bontango/Gosof80/top/GOSOF80.vhd

-- Top level file for a Gottlieb compatible Soundboard
-- by bontango www.lisy.dev
-- 
-- This is free software: you can redistribute
-- it and/or modify it under the terms of the GNU General
-- Public License as published by the Free Software
-- Foundation, either version 3 of the License, or (at your
-- option) any later version.
--
-- This is distributed in the hope that it will
-- be useful, but WITHOUT ANY WARRANTY; without even the
-- implied warranty of MERCHANTABILITY or FITNESS FOR A
-- PARTICULAR PURPOSE. See the GNU General Public License
-- for more details.
--
-- HW 'GOSOF80' v2.1
-- Version 0.1 - rom read from SD card
-- Version 0.2 - rom read from SD card MA 216 & MA390
-- Version 0.3 - added MA55 support
-- Version 0.4 - with option DIP4 to on, romcode is read always from first secor ( sector #660 in fact)
-- Version 0.5 - MA490 support (SYS1 works partially)
-- Version 0.6 - SYS1 support
-- Version 0.7 - added Rocky
-- Version 0.8 - sb_opt(6) was on wrong IO ( PIN_51 instead of PIN_93)
---- 			 	- remark: sys1 playing only '10' & '1000' sounds is OK while game over is high!!
-- Version 0.9 - added background music with SYS1 & MA55
-- Version 0.91 -- added clock adjustment via options
-- Version 0.92 -- added matrix for striker & Qbert
-- Version 0.93 -- with LED_1 showing playing sounds
-- Version 0.94 -- activated folder 64 with all DIPs ON, CPU deactivated in this case
-- Version 0.95 -- added Caveman
-- Version 0.96 -- corrected Mars
-- Version 0.97 - attract speech for Mars, Volcano and Black Hole
-- Version 0.98 - Votrax SC-01 emulation (rtl/common/votrax, PinMAME's SC-01 model) for
--                MA-216 games, selected with DIP 2 ON. DIP 2 OFF = speech from MP3 as
--                before. Not on Cyclone II (variant_pkg HAS_VOTRAX = false).
--                Audio DAC now 10 bit: sound DAC + speech mixed with saturation.
--                Speech 1.0 = 512, tones x3 instead of x4 while the emulation runs.
--                HW 4.x (v4.01: CRC check, sound test, PLL) joins this tree as board 5.
--                Clock and option DIPs of HW 2.x as on HW 4.x, option DIPs (ON = '0'):
--                  DIP1 ON  CPU 1020 kHz, OFF 892 kHz (Gosof_PLL; was a 7 step divider)
--                  DIP2 ON  speech from the MP3 player, OFF Votrax emulation (MA-216)
--                  DIP3 ON  test switch = test switch of the original board,
--                       OFF test switch says "This is Gosof version x.98 from lisy dot dev"
--                  DIP4 ON  test mode: every sound as number from MP3 folder 64
--                           (was game_sel 000000 on HW 2.x; DIP4 "ROM from sector 660" is gone)
-- Version 0.99 - sound inputs S1..S16 are taken over only after they were stable for
--                SETTLE_CYCLES cpu_clk cycles (about 1 ms). Speech games drive S16 through the
--                driver board, it arrives later than S1..S8. The MA-216 program reads port A
--                once, about 20 cycles after the PA7 IRQ, and missed S16: no speech in the
--                game with the Votrax emulation (Black Hole, DIP 2 OFF). The MP3 path sent the
--                wrong file for sounds whose lower bits are speech themselves (BH 19, 29, 31).
--
-- Shared core of all board variants (HW 2.x: Cyclone II, Cyclone IV v3/v4, Cyclone 10;
-- HW 4.x: Cyclone 10). The board shells top\board_hw2x.vhd / top\board_hw4x.vhd
-- (entity gosof80) map their pins onto it; the SD card reader comes per board family
-- as entity sd_reader. Releases are named <BoardId>.<SwMinor>, e.g. 3.98 - board id in
-- variant.psd1, SwMinor in scripts\version.psd1, both reach the VHDL as generics
-- (set_parameter in the generated .qsf).

library ieee;
use ieee.std_logic_1164.all;
use ieee.numeric_std.all;
use work.variant_pkg.all;

entity gosof80_core is
	generic(
		BOARD_ID : natural := 0;
		SW_MINOR : natural := 0
	);
	port(
		clk_50	: in std_logic;
		reset_sw	: in std_logic;
		test_sw	: in std_logic;  -- test switch (Gottlieb test), '0' = pressed
		gosof_test	: in std_logic;  -- sound test switch (HW 4.x only), '0' = pressed
		Audio_O	: buffer std_logic;

		-- Sound input S1,S2,S4,S8,S16
		-- initial low due to 2803A on input of Gosof80
		Sound :	in 	std_logic_vector(4 downto 0);

		--Soudnboard Options S1 DIPs 1..6
		SB_Opt :	in 	std_logic_vector(1 to 6);

		game_sel	:	in 	std_logic_vector(5 downto 0);  -- game selection S2
		option   :	in 	std_logic_vector(3 downto 0);  -- GOSOF options

		-- signals for the board LEDs
		trigger_o	: out std_logic;  -- one of S1..S8 active
		pa7_o			: out std_logic;  -- RIOT PA7 (sound strobe as the CPU sees it)
		sd_error_o	: out std_logic;
		crc_error_o	: out std_logic;  -- '0' = CRC error (HW 4.x), '1' on HW 2.x

		-- DFPlayer
		DFP_txd	   : out STD_LOGIC;

		-- SDcard
		SD_CS : buffer 	std_logic;
		SD_MISO : in 	std_logic;
		SD_MOSI : buffer 	std_logic;
		SD_CLK : buffer 	std_logic

		);
end gosof80_core;

architecture rtl of gosof80_core is

	-- multi SD, type according to game select
	constant is_MA216 : std_logic_vector(2 downto 0):="000";
	constant is_MA309 : std_logic_vector(2 downto 0):="001";
	constant is_MA55 : std_logic_vector(2 downto 0):="010";
	constant is_MA490 : std_logic_vector(2 downto 0):="011";
	constant is_SYS1 : std_logic_vector(2 downto 0):="100";
	constant is_special : std_logic_vector(2 downto 0):="101";

	signal SB_type : 	std_logic_vector(2 downto 0);
	
	signal cpu_clk	   : std_logic; -- 892 KHz clock
	signal clk_892	   : std_logic; -- 892 KHz clock (Gosof_PLL c0)
	signal clk_1042	   : std_logic; -- 1020 KHz clock (Gosof_PLL c1, called 1042 since HW 4.x)
	signal phi2			: 	std_logic; -- CPU clock phase 2
	signal uart_clk	: std_logic; -- 9600 baud clock for uart
	signal reset_l		: 	std_logic; -- Ccontroled by SD card reader

	-- option DIPs (ON = '0' on the pin)
	signal opt_fast		: std_logic; -- DIP1 ON: CPU 1020 kHz
	signal opt_test		: std_logic; -- DIP4 ON: test mode, sounds as numbers (MP3 folder 64)
	signal test_game		: std_logic; -- test switch as the game sees it

	signal Sound_meta : 	std_logic_vector(4 downto 0);
	-- input settle filter (v0.99): 1000 cycles = 1.12 ms at 892 kHz, 0.98 ms at 1020 kHz
	constant SETTLE_CYCLES : natural := 1000;
	signal Sound_last   : 	std_logic_vector(4 downto 0) := (others => '0');
	signal Sound_stable : 	std_logic_vector(4 downto 0) := (others => '0');
	signal settle_cnt   : 	natural range 0 to SETTLE_CYCLES := 0;
	signal Sound_in : 	std_logic_vector(4 downto 0);   -- Sound_stable or the sound test
	signal trigger_sound	: std_logic;
	signal test_activ		: std_logic;
	signal test_sound		: std_logic_vector(4 downto 0);
	signal cpu_addr	:	std_logic_vector(15 downto 0);
	signal cpu_din		: 	std_logic_vector(7 downto 0);
	signal cpu_dout	:  std_logic_vector(7 downto 0);
	signal n_cpu_nmi	: 	std_logic;
	signal n_cpu_irq	:  std_logic;
	signal cpu_wr_n	:  std_logic;
	
	signal riot_dout	:  std_logic_vector(7 downto 0);
	signal riot_pa_i	:  std_logic_vector(7 downto 0);
	signal riot_pa_o	:  std_logic_vector(7 downto 0);
	signal riot_pb_i	:  std_logic_vector(7 downto 0);
	signal riot_pb_o	:	std_logic_vector(7 downto 0);
	signal riot_cs		:  std_logic;
	signal n_riot_irq : std_logic;
	signal riot_rs_n  : std_logic;	
	signal addr_6532  :	std_logic_vector(4 downto 0);
	
	-- ROM
	signal soundrom1_dout	:	std_logic_vector(7 downto 0);
	signal soundrom2_dout	: 	std_logic_vector(7 downto 0);	
	
	-- address decoding helper
	signal soundrom1_cs		: std_logic;
	signal soundrom2_cs		: std_logic;
	signal soundrom1_addr	:  std_logic_vector(10 downto 0);
	signal soundrom2_addr	:  std_logic_vector(10 downto 0);
	signal wr_soundrom1		: std_logic;
	signal wr_soundrom2		: std_logic;
			
	-- RAM
	signal RAM_dout	: 	std_logic_vector(7 downto 0);
	signal RAM_cs		:  std_logic;
    
	-- sounds
	signal DAC_latch	:  std_logic;
	signal audio_dat_latch	: 	std_logic_vector(7 downto 0);
   signal audio_dat	: 	std_logic_vector(7 downto 0);	
	
	-- speech
	signal DAC_latch_speech	:  std_logic;
	signal sc01_strobe	:  std_logic;
	signal sc01_AR			:  std_logic;
	signal sc01_cs			:  std_logic;
	signal sc01_AR_timing	:  std_logic; -- A/R of the old timing-only SC01 (MP3 speech)

	-- Votrax SC-01 emulation (MA-216, option DIP 2 OFF) and the version announcement
	signal votrax_on		:  std_logic;
	signal vtx_ar			:  std_logic;
	signal vtx_audio		:  signed(15 downto 0);
	signal audio_mix		:  std_logic_vector(9 downto 0);
	signal ann_enable		:  std_logic; -- option DIP 3 OFF: test switch says the version
	signal ann_busy		:  std_logic;

	signal send_flag	:  std_logic:='0';
	signal DFcmd_cmd	:  std_logic_vector(7 downto 0);
	signal DFcmd_par1	:  std_logic_vector(7 downto 0);
	signal DFcmd_par2	:  std_logic_vector(7 downto 0);	
	
	-- background sound 
	signal bg_send_flag	:  std_logic:='0';
	signal bg_DFcmd_cmd	:  std_logic_vector(7 downto 0);
	signal bg_DFcmd_par1	:  std_logic_vector(7 downto 0);
	signal bg_DFcmd_par2	:  std_logic_vector(7 downto 0);	
	
	signal speech_ctrl :  std_logic_vector(31 downto 0);
	
	-- SD card
	signal address_sd_card	:  std_logic_vector(15 downto 0);
	signal data_sd_card	:  std_logic_vector(7 downto 0);
	signal wr_rom			:  std_logic;
	signal bg_on			:  std_logic; -- background music via the MP3 player
			
	-- MA490 only	
	signal ma490_irq_n			: std_logic;
	signal ma490_U11_q			: std_logic;
	
	-- attract mode
	signal attract_sound	:  std_logic_vector(7 downto 0);
	signal attract_send_flag	:  std_logic:='0';	
	signal number_of_attract_sounds : integer;
		
begin

-- do some signaling (the board shell drives its LEDs from these)
trigger_o <= trigger_sound;
pa7_o <= riot_pa_i(7);

-- option DIPs, see the header
opt_fast <= not option(0);
opt_test <= not option(3);

-- what type of soundboard do we emulate?
	SB_type <=  is_MA216 when game_sel( 5 downto 3) = "111" else
					is_MA309 when game_sel( 5 downto 4) = "11" else
					is_MA55 when game_sel( 5 downto 4) = "10" else
					is_MA490 when game_sel( 5 downto 4) = "01" else
					is_SYS1 when game_sel( 5 downto 4) = "00" else
					is_special;

	
META1: entity work.Cross_Slow_To_Fast_Clock_Bus
port map(
   i_D => Sound,
	o_Q => Sound_meta,
   i_Fast_Clk => cpu_clk	
	--i_Fast_Clk => clk_50
	);

-- settle filter (v0.99): Sound_stable follows Sound_meta only after all five lines were
-- unchanged for SETTLE_CYCLES. S16 comes through the driver board of the game and arrives
-- later than S1..S8; without the filter the PA7 IRQ fired and the MA-216 program read
-- port A before S16 was there.
Settle: process(cpu_clk) is
begin
	if rising_edge(cpu_clk) then
		if Sound_meta /= Sound_last then
			Sound_last <= Sound_meta;
			settle_cnt <= 0;
		elsif settle_cnt < SETTLE_CYCLES then
			settle_cnt <= settle_cnt + 1;
		else
			Sound_stable <= Sound_last;
		end if;
	end if;
end process;

-- sound test (HW 4.x, switch Gosof_Test): plays sound 1..31, 5 s each
Sound_in <= Sound_stable when test_activ = '0' else test_sound;

gen_soundtest: if IS_HW4 generate
	STEST: entity work.soundtest
	port map(
		i_Rst_L	=> reset_l,
		clk_in	=> uart_clk,
		start 	=> gosof_test,
		test_activ => test_activ,
		sound => test_sound
		);
end generate;
gen_no_soundtest: if not IS_HW4 generate
	test_activ <= '0';
	test_sound <= (others => '0');
end generate;

DFP_send: entity work.DFPlayer_Mini_CMD
port map(
			DFcmd_cmd => DFcmd_cmd,
			DFcmd_par1 => DFcmd_par1,
			DFcmd_par2 => DFcmd_par2,
         send_flag => send_flag,
         clk => uart_clk,
         rst => reset_l,
         txd => DFP_txd
);

-- timing only SC-01 (A/R), used while the speech comes from the MP3 player
SC01_Simu: entity work.SC01
port map(
         clk => clk_50,
			strobe => sc01_strobe,
			cpu_data => cpu_dout(5 downto 0),
			AR => sc01_AR_timing,
         rst => reset_l
);

-- Votrax SC-01 emulation: MA-216 games with option DIP 2 OFF (not in the test mode,
-- which plays numbers from MP3). Then MP3 speech and attract MP3 are off.
votrax_on <= '1' when HAS_VOTRAX and SB_type = is_MA216 and option(1) = '1' and opt_test = '0' else '0';
-- while the version announcement runs, the CPU sees a ready SC-01 (no NMIs from A/R)
sc01_AR <= sc01_AR_timing when votrax_on = '0' else
           '1' when ann_busy = '1' else
           vtx_ar;

-- Test switch: with option DIP 3 OFF (and the emulation built in) it says the version,
-- the game sees it open. With DIP 3 ON it is the test switch of the original board.
ann_enable <= '1' when HAS_VOTRAX and option(2) = '1' else '0';
test_game <= '1' when ann_enable = '1' else test_sw;

gen_votrax: if HAS_VOTRAX generate
	signal speech_clk_latch	:  std_logic_vector(7 downto 0); -- $3000, SC-01 clock
	signal vtx_mute_stb		:  std_logic;
	signal vtx_stb			:  std_logic;
	signal vtx_data		:  std_logic_vector(7 downto 0);
	signal vtx_clk_ctrl	:  std_logic_vector(7 downto 0);
	signal ann_start		:  std_logic;
	signal ann_stb			:  std_logic;
	signal ann_data		:  std_logic_vector(7 downto 0);
	signal test_s			:  std_logic_vector(2 downto 0) := "111";
	signal deb_cnt			:  unsigned(19 downto 0) := (others => '0'); -- 21 ms at 50 MHz
	signal test_deb		:  std_logic := '1';
begin
	-- debounce the test switch: a level counts once it held for 2^20 clocks (21 ms)
	Test_Debounce: process(clk_50) is
	begin
		if rising_edge(clk_50) then
			test_s <= test_s(1 downto 0) & test_sw;
			ann_start <= '0';
			if test_s(2) = test_deb then
				deb_cnt <= (others => '0');
			else
				deb_cnt <= deb_cnt + 1;
				if deb_cnt = (deb_cnt'range => '1') then
					test_deb <= test_s(2);
					ann_start <= ann_enable and not test_s(2);  -- pressed
				end if;
			end if;
		end if;
	end process;

	ANNOUNCE: entity work.vtx_announce
	generic map (BOARD_ID => BOARD_ID, SW_MINOR => SW_MINOR)
	port map(
		clk   => clk_50,
		rst_n => reset_l,
		start => ann_start,
		ar    => vtx_ar,
		busy  => ann_busy,
		stb   => ann_stb,
		data  => ann_data
	);

	-- $3000: D/A converter for the SC-01 clock (0x7E = 720 kHz, games lower it for TILT)
	Speech_Clock_Latch: process(clk_50) is
	begin
		if rising_edge(clk_50) then
			if reset_l = '0' then
				speech_clk_latch <= x"7E";
			elsif dac_latch_speech = '1' then
				speech_clk_latch <= cpu_dout;
			end if;
		end if;
	end process;

	-- PinMAME gts80s.c: a write to $7000-$7FFF (the ROM area, the program writes there
	-- as a delay) mutes the speech until the next phoneme write to $2000
	vtx_mute_stb <= '1' when cpu_addr(14 downto 12) = "111" and cpu_wr_n = '0' and cpu_clk = '0'
	                         and votrax_on = '1' and ann_busy = '0' else '0';

	-- the bus of the SC-01: the announcement while it runs, else the MA-216 CPU
	vtx_stb      <= ann_stb when ann_busy = '1' else sc01_strobe and votrax_on;
	vtx_data     <= ann_data when ann_busy = '1' else cpu_dout;
	vtx_clk_ctrl <= x"7E" when ann_busy = '1' else speech_clk_latch;

	VOTRAX: entity work.votrax_sc01
	generic map (G_TICK_DIV => 0)
	port map(
		clk       => clk_50,
		rst_n     => reset_l,
		stb       => vtx_stb,
		data      => vtx_data,
		mute_stb  => vtx_mute_stb,
		clk_ctrl  => vtx_clk_ctrl,
		ar        => vtx_ar,
		audio     => vtx_audio,
		audio_stb => open,
		tick_o    => open
	);
end generate;
gen_no_votrax: if not HAS_VOTRAX generate
	vtx_ar    <= '1';
	vtx_audio <= (others => '0');
	ann_busy  <= '0';
end generate;


-- phase 2 is complement of CPU clock
phi2 <= not(cpu_clk); 

-- IRQ signals ( should be '1')
n_cpu_irq <= n_riot_irq when ( SB_type = is_MA216 or SB_type = is_MA309 ) else
				 ma490_irq_n when ( SB_type = is_MA490 ) else
				 '1';

-- JK flip-flop on the piggyback board triggers CPU IRQ
ma490_U11_q <= not (riot_pb_i(0) or riot_pb_i(1) or riot_pb_i(2) or riot_pb_i(3));
U10: process(ma490_U11_q, riot_pb_o(6))
begin
	if riot_pb_o(6) = '0' then
		ma490_irq_n <= '1';
	elsif falling_edge(ma490_U11_q) then 
		ma490_irq_n <= '0';
	end if;
end process;

-- Address decoding here, cpu address bus 14-12 connect to 74LS138, only a few are used on non-speech board
--'000' riot cs
--'001' dac latch (sound)
--'010' SC01 latch 
--'011' dac latch (speech)
--'111' rom enable
riot_rs_n <= cpu_addr(9); -- ram select for riot RS_N = '0' do select ram
riot_cs 		<= '1' when cpu_addr(14 downto 12) ="000" and riot_rs_n='1' and ( SB_type = is_MA216 or SB_type = is_MA309 ) else
					'1' when cpu_addr(11 downto 10) ="00" and riot_rs_n='1' and ( SB_type = is_MA55 or SB_type = is_MA490 or SB_type = is_SYS1 ) else
					 '0';
ram_cs 		<= '1' when cpu_addr(14 downto 12) ="000" and riot_rs_n='0' and ( SB_type = is_MA216 or SB_type = is_MA309 ) else
					'1' when cpu_addr(11 downto 10) ="00" and
					riot_rs_n='0' and ( SB_type = is_MA55 or SB_type = is_MA490 or SB_type = is_SYS1 ) else
					'0';
soundrom1_cs 		<= '1' when cpu_addr(14 downto 11) ="1110" and ( SB_type = is_MA216 or SB_type = is_MA309 ) else
							'1' when cpu_addr(11 downto 10) ="01" and ( SB_type = is_MA55 or SB_type = is_SYS1 )else -- 0x0400 - 0x07FF & Mirror 0x0800 - 0x0BFF
							'1' when cpu_addr(11 downto 10) ="10" and ( SB_type = is_MA55 or SB_type = is_SYS1 )else -- Mirror 0x0800 - 0x0BFF
							'1' when cpu_addr(11) ='1' and SB_type = is_MA490 else
							'0';
soundrom2_cs 		<= '1' when cpu_addr(14 downto 11) ="1111" and ( SB_type = is_MA216 or SB_type = is_MA309 ) else
							'1' when cpu_addr(11 downto 10) ="11" and ( SB_type = is_MA55 or SB_type = is_SYS1 ) else -- 0x0C00 - 0x0FFF
							'0';
					
--MA only					
dac_latch 	<= '1' when cpu_addr(14 downto 12) ="001" and cpu_wr_n='0' else '0';
dac_latch_speech 	<= '1' when cpu_addr(14 downto 12) ="011" and cpu_wr_n='0' else '0';
SC01_cs <= '1' when cpu_addr(14 downto 12) ="010" and cpu_wr_n='0' else '0';
-- strobe is an AND of cs for SC-01, phi1 negated and Q1 negate from U2
sc01_strobe 	<= SC01_cs and not cpu_clk;
--sc01_strobe 	<= '1' when cpu_addr(14 downto 12) ="010" and cpu_wr_n='0' else '0';

-- address selection	
-- read from SD when wr_rom == 1
-- else map to address room

-- content of sound rom 1 is read from first 2K of SD
wr_soundrom1 <= '1' when ((wr_rom='1') and (address_sd_card(15 downto 11) ="00000" )) else '0';
soundrom1_addr <=  --2K
	address_sd_card(10 downto 0) when wr_soundrom1 = '1' else
	'0' & cpu_addr(9 downto 0) when (SB_type = is_MA55 or SB_type = is_SYS1) else -- MA55 and SYS1 have only 1K rom
	cpu_addr(10 downto 0);

-- content of sound rom 2 is read from second 2K of SD
wr_soundrom2 <= '1' when ((wr_rom='1') and (address_sd_card(15 downto 11) ="00001" )) else '0';
soundrom2_addr <=  --2K
	address_sd_card(10 downto 0) when wr_soundrom2 = '1' else
	'0' & cpu_addr(9 downto 0) when (SB_type = is_MA55 or SB_type = is_SYS1) else -- MA55 and SYS1 have only 1K rom
	cpu_addr(10 downto 0);

	
-- Bus control
cpu_din <= 
   ram_dout when ram_cs = '1' else
	riot_dout when riot_cs = '1' else
	soundrom1_dout when soundrom1_cs = '1' else
	soundrom2_dout when soundrom2_cs = '1' else	
	x"FF";
		
-- speech ctrl
-- speech_ctrl 0 is speech (-> MP3-Player), 1 is 'other'		
-- starting with sound #31 down to sound #0

speech_ctrl <=
"00000000000000000000000000000001" when opt_test = '1' else  --folder 64 , numbers as wav
"11111111111111111111111111111101" when game_sel = "100111" else  --Pink Panther
																		 
"00000100000000010111100111100111" when game_sel = "111111" else  --Mars
"00010000011000110110001101100111" when game_sel = "111110" else --Volcano
"00000000001111110101111111110111" when game_sel = "111101" else  --Black Hole						
"00111111101001011011111111111111" when game_sel = "111100" else  --Devils Dare
"00000000000111111111111111111111" when game_sel = "111011" else  --Rocky
"00000111111110110111111111110111" when game_sel = "111010" else  --Striker
"11111111111111110000111101110101" when game_sel = "111001" else  --Q*Bert's Quest
"00000111111110111111111111111011" when game_sel = "111000" else  --Caveman
"11111111111111111111111111111111"; -- no speech

-- RIOT_PA
-- input for MA216 & MA309
-- MA55 use PA_out for 1408 DAC
--Sound board inputs through RIOT port A via GOSOF 
-- use not sound for benchtest with 2803A
riot_pa_i(0) <= Sound_in(0);
riot_pa_i(1) <= Sound_in(1);
riot_pa_i(2) <= Sound_in(2);
riot_pa_i(3) <= Sound_in(3);
riot_pa_i(4) <= Sound_in(4);
riot_pa_i(5) <= '0'; -- wired, but not used
riot_pa_i(6) <= '0'; -- not wired, not used
-- Strobe signal generates IRQ when one of the inputs S1-S8 go low
-- we do this also for speech as the SB may want to stop current sound
trigger_sound <= ( Sound_in(0) or Sound_in(1) or Sound_in(2) or Sound_in(3));
riot_pa_i(7) <= trigger_sound and not opt_test; -- no trigger in sound as numbers testmode

-- RIOT PB
---
-- switches
--dip switch	1	2	3	4	5	6	7	8
--PB				3	J1	5	4	2	1	0	J1
--pin riot		21		18	19	22	23	24	
--
--Test attract mode and speech off for Mars
-- Manual: Switch ON -> 0, Switch OFF -> 1
riot_pb_i(0) <= Sound_in(0) when ( SB_type = is_MA55 or SB_type = is_MA490 or SB_type = is_SYS1 ) else
				    '1'; -- DIP7 not wired on Gosof PCB
riot_pb_i(1) <= Sound_in(1) when ( SB_type = is_MA55 or SB_type = is_MA490 or SB_type = is_SYS1 ) else
					 SB_Opt(6); --DIP6
riot_pb_i(2) <= Sound_in(2) when ( SB_type = is_MA55 or SB_type = is_MA490 or SB_type = is_SYS1 ) else
					 SB_Opt(5); --DIP5
riot_pb_i(3) <= Sound_in(3) when ( SB_type = is_MA55 or SB_type = is_MA490 or SB_type = is_SYS1 ) else
					 SB_Opt(1); --DIP1
riot_pb_i(4) <= SB_Opt(4) when (SB_type = is_MA216 or SB_type = is_MA309) else --DIP4
					 SB_Opt(2); --MA55 and MA490 -- Attract mode sounds enable (S2 on board)
riot_pb_i(5) <= cpu_addr(10) when ( SB_type = is_MA55 or SB_type = is_SYS1 ) else --CS2 (needed?)
					 SB_Opt(3); --DIP3
riot_pb_i(6) <= '0' when ( SB_type = is_MA55 or SB_type = is_MA490 ) else  -- S16 Spare not used by games with MA-55 and MA490
					  Sound_in(4) when ( SB_type = is_SYS1 ) else -- 5 inputs with System1 'Multisound'
					  test_game; -- connected to Testswitch against ground with MA216 & MA390
--for MA216 we have also a wire to A/R of SC01 ( is pB7 a input or a output IO?)
-- jumpered to Vcc in most games, can be strapped to riot PB7 out;
riot_pb_i(7) <= not sc01_AR when SB_type = is_MA216 else
					 SB_Opt(1) when ( SB_type = is_MA55 or SB_type = is_MA490 or SB_type = is_SYS1 ) else --Sound or tones mode (DIP1), many games lack tone support and require this to be high (OFF)
					'1'; -- '1' for MA309 and games with no speech
n_cpu_nmi <=  not sc01_AR when SB_type = is_MA216 else 
				  test_game when ( SB_type = is_MA55 or SB_type = is_MA490 or SB_type = is_SYS1 ) else 
				  '1'; -- '1' for MA309 and games with no speech
-- DIP8 not wired on Gosof PCB


DFP_bg: entity work.background_sound
port map(   
         clk => uart_clk,
         rst => reset_l,
			game_over => Sound_in(4),
			folder => x"09",
			DFcmd_cmd => bg_DFcmd_cmd,
			DFcmd_par1 => bg_DFcmd_par1,
			DFcmd_par2 => bg_DFcmd_par2,
         send_flag => bg_send_flag
);


-- number of attract sounds(speeches) possible
number_of_attract_sounds <= 3 when game_sel = "111111" else  --Mars
3 when game_sel = "111110" else --Volcano
2 when game_sel = "111101" else  --Black Hole						
0;

Attract_S: entity work.attract
port map(   			
         clk => clk_50,
			clk_uart => uart_clk,
         rst => reset_l,
			other_sound => riot_pa_i(7),
			options => SB_Opt(4) & SB_Opt(3),
			num_sounds => number_of_attract_sounds,
			soundnumber => attract_sound,
         send_flag => attract_send_flag
);

-- prepare date for MP3 Player	      	  
-- Folder selection wav files
-- background music: System 1 and MA-55 (all boards as HW 2.x; HW 4.x v4.01 had dropped MA-55), not in the test mode
bg_on <= '1' when (SB_type = is_SYS1 or SB_type = is_MA55) and opt_test = '0' else '0';

DFcmd_cmd <= bg_DFcmd_cmd when bg_on = '1' else X"0F"; -- cmd for folder to playback

DFcmd_par1 <=
X"40" when opt_test = '1' else  -- folder 64 - Test (numbers as wav)
X"0A" when game_sel = "111111" else  -- folder 10 Mars
X"0C" when game_sel = "111110" else -- folder 12 Volcano
X"0E" when game_sel = "111101" else  -- folder 14 Black Hole						
X"12" when game_sel = "111100" else  -- folder 18 Devils Dare
X"14" when game_sel = "111011" else  -- folder 20 - Rocky
X"17" when game_sel = "111010" else  -- folder 23 - Striker
X"19" when game_sel = "111001" else  -- folder 25 - Q*Bert's Quest
X"3F" when game_sel = "111000" else  -- folder 63 - Caveman
X"00"; --default 0 (e.g. for SYS1)
--

DFcmd_par2 <=  bg_DFcmd_par2 when bg_on = '1'
					  else attract_sound when attract_send_flag = '1'
					  else "000" & Sound_in;

send_flag <= bg_send_flag when bg_on = '1' else
				  '0' when votrax_on = '1' else -- speech (also in attract mode) from the SC-01 emulation
				  trigger_sound when speech_ctrl(to_integer(unsigned(Sound_in))) = '0' else
				  attract_send_flag;
				
	
					 
					   
											   
											
					  

-- RAM
RIOT_RAM: entity work.RAM -- RIOT internal RAM 128Byte
port map(
	address	=> cpu_addr(6 downto 0),
	clock		=> clk_50, 
	data		=>  cpu_dout (7 DOWNTO 0),
	wren 		=> ram_cs and not cpu_wr_n,
	q			=> ram_dout
);

-- 9600 baud send clock
uart_gen: entity work.uart_clk_gen 
port map(   
	clk_in => clk_50,
	uart_clk_out	=> uart_clk
);

-- cpu clock 892 kHz or 1020 kHz (option DIP 1 ON), as on HW 4.x. Gosof_PLL is the ALTPLL on
-- Cyclone IV/10 and a plain divider on Cyclone II (rtl\cyclone_*\Gosof_PLL.vhd).
PLL: entity work.Gosof_PLL
port map(
	inclk0 => clk_50,
	c0 => clk_892,
	c1 => clk_1042
	);

cpu_clk <= clk_1042 when opt_fast = '1' else clk_892;

-- 6502 CPU
CPU : entity work.T65
port map(
	Enable => '1',
	Mode => "00",
	Res_n => reset_l,
	Clk => cpu_clk,
	Rdy => '1',
	Abort_n => '1',
	IRQ_n => n_Cpu_irq,
	NMI_n => n_Cpu_nmi,
	SO_n => '1',
	R_W_n => cpu_wr_n,
	A(15 downto 0) => cpu_addr,
	DI => cpu_din,
	DO => cpu_dout
);	

-- we use a 6532 also for MA55 and MA490, so we have to adjust the address
addr_6532 <= cpu_addr(4 downto 0) when (SB_type = is_MA216 or SB_type = is_MA309) else
				  '1' & cpu_addr(3 downto 0);
				  
 
 
-- 6532 RAM-IO-Timer	
RIOT : entity work.R6532
port map(
	PHI2 		=> phi2, 	
	RST_N 	=> reset_l, 
	CS			=> riot_cs,
	RW_n 		=> cpu_wr_n,
	IRQ_N		=> n_riot_irq,
	
	ADD			=> addr_6532,
	DIN		=> cpu_dout,
	DOUT		=> riot_dout,
	
   PA_IN		=> riot_pa_i,
	PA_OUT		=> riot_pa_o,
   PB_IN		=> riot_pb_i,
	PB_OUT		=> riot_pb_o	

);

--Latch for pulling DAC data from the CPU data bus
Audio_DAC_Latch: Process(clk_50) is
Begin
	If rising_edge(clk_50) then
		if dac_latch = '1' then
			audio_dat_latch <= cpu_dout;
		end if;		
	end if;
end process;

-- different audio sources for MA216/Ma309 and other soundboards
audio_dat <= audio_dat_latch when ( SB_type = is_MA216 or SB_type = is_MA309) else
				 riot_pa_o;
				 
				 
-- Mixer: sound DAC (8 bit, 0x80 = silence) + SC-01 speech, 10 bit for the DAC.
-- Without speech the 10 bit value is audio_dat & "00", i.e. exactly the old level.
-- Speech: 1.0 (= 8192, PinMAME's output scale) -> 512 = the sound DAC's full scale.
-- x.98 had 256 (far too quiet on hardware), 768 was loud enough but audibly harsher.
-- Speech peaks at ~1.1 but its RMS is only ~0.14, so only ~0.06 % of the speech
-- samples hit the limit; the sum saturates.
-- With the emulation on, the sound DAC is scaled x3 instead of x4 (-2.5 dB): with speech
-- x2 the tones were still a bit louder than the speech. MP3 mode keeps the old level.
-- The version announcement is mixed in whenever it runs, on top of the tone level in use.
Audio_Mixer: process(clk_50) is
	variable d : integer range -128 to 127;
	variable s : integer range -4096 to 4095;
begin
	if rising_edge(clk_50) then
		d := to_integer(unsigned(audio_dat)) - 128;
		if votrax_on = '1' then
			s := d * 2 + d;
		else
			s := d * 4;
		end if;
		if votrax_on = '1' or ann_busy = '1' then
			s := s + to_integer(shift_right(vtx_audio, 4));
		end if;
		if s > 511 then s := 511; elsif s < -512 then s := -512; end if;
		audio_mix <= std_logic_vector(to_unsigned(s + 512, 10));
	end if;
end process;

-- Delta-Sigma audio DAC
Audio_DAC : entity work.dac
generic map(
  msbi_g => 9)
port  map(
   clk_i   => clk_50,
   res_n_i => reset_l,
   dac_i   => audio_mix,
   dac_o   => audio_O
);

---------------------
-- SD card stuff
----------------------

-- sd_reader is the SD card reader of the board family (rtl\common\sd_reader_hw2x.vhd:
-- 4 KB per game; rtl\hw4x\sd_reader_hw4x.vhd: 64 KB per game with CRC check)
SD_CARD: entity work.sd_reader
port map(
	clk		=> clk_50,
   rst_l  => reset_sw,
   spi_clk  => SD_CLK,
   spi_miso => SD_MISO,
   spi_mosi => SD_MOSI,
   spi_cs_n => SD_CS,
	selection => "00" & not game_sel(5 downto 0),
	address_sd_card => address_sd_card,
	data_sd_card => data_sd_card,
	wr_rom => wr_rom,
	cpu_reset_l => reset_l,
	sd_error => sd_error_o,
	crc_error => crc_error_o
	);
	
-- soundrom1 for MA219/MA309
-- soundrom for MA55 and others	
SOUNDROM1: entity work.SB_ROM -- ROM 2KByte
port map(
	address	=> soundrom1_addr,  -- 10 downto 0
	clock		=> clk_50, 
	data 		=> data_sd_card,
	wren 		=> wr_soundrom1,
	q			=> soundrom1_dout
	);

-- soundrom2 for MA219/MA309
-- maskrom (R6530 internal) for MA55 and others	
SOUNDROM2: entity work.SB_ROM -- ROM 2KByte
port map(
	address	=> soundrom2_addr,  -- 10 downto 0
	clock		=> clk_50, 
	data 		=> data_sd_card,
	wren 		=> wr_soundrom2,
	q			=> soundrom2_dout
	);

	
end rtl;
