bontango/Gosof80/(commit log)

2026-10-14 GOSOF80 HW2.x: gemeinsamer Sourcebaum fuer vier Varianten
    Die vier Quartus-Ordner GOSOF80_HW2x_CycloneII/_CycloneIV_v3/_CycloneIV_v4/
    _Cyclone10 aus FPGA_source (jetzt FPGA_source_alt) auf einen Baum gelegt:
    ein top/GOSOF80.vhd, rtl/common + rtl/<familie>, je Variante device.tcl,
    pins.tcl und variant.psd1, generierte .qsf, Baseline-Check.
    Die Historie beginnt hier; die alten Ordner hatten kein Git.
    - .qsf Zuweisung fuer Zuweisung identisch zur alten (nach Pfadumschreibung)
    - Cyclone II: Synthese, LE und Slack identisch zur Baseline
    - Cyclone IV/10: im Altbestand fehlte GOSOF80.sdc (Critical Warning 332012);
    jetzt gemeinsam in rtl/common. Ohne SDC-Zeile reproduziert der neue Baum die
    al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
    [baseline.csv]
2026-10-14 hw2x_cyclone_II: Hold-Timing per OPTIMIZE_HOLD_TIMING "ALL PATHS" erfuellt
    Mit der Quartus-13.0-Voreinstellung (nur I/O-Pfade) war Hold auf den
    registergeteilten Takten verletzt: uart_clk_out -1.857 ns (attract|sound_seen
    -> reset_flag/counter), cpu_clk_out -1.014 ns (SD_Card|cpu_reset_l -> RIOT).
    Jetzt Hold +0.499 / +0.215 ns, Setup 3.853 -> 4.359 ns, Synthese unveraendert
    (2161/791/33792). Die Ursache (abgeleitete Takte) bleibt, siehe VARIANTEN.md.
    [baseline.csv]
2026-10-14 x.98: Votrax SC-01 Emulation fuer MA-216 (DIP 2 ON), nicht auf Cyclone II
    rtl/common/votrax/votrax_sc01.vhd bildet PinMAMEs SC-01-Modell nach
    (src/sound/votrax.c, Galibert-Kern, Commit 0e489b2): Phonem-ROM, chip_update,
    Timer/A-R, analog_calc als 14 MAC-Operationen auf einem 27x24-Multiplizierer.
    Haupttakt per NCO aus dem $3000-Latch (TILT), Mute bei Schreiben auf $7000.
    - Filter von votrax.c sind Biquads (gemeinsamer Faktor 1+z^-1), Koeffizienten
    taktunabhaengig -> vorberechnete ROMs (sim/votrax/tools/gen_votrax_tables.py)
    - Top-Level: DIP 2 ON bei MA-216 = Emulation, MP3-Sprache/Attract-MP3 aus;
    10-Bit-Mischer vor dem DAC (ohne Sprache gleicher Pegel wie bisher)
    - variant_pkg.vhd je V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
    [baseline.csv]
2026-10-15 x.98: Sprachpegel x2, Toene x3/4 bei aktiver Votrax-Emulation
    Hoertest auf hw2x_cyclone_IV_v4 (15.10.2026): Sprache mit 1.0 = 256 viel zu leise,
    x3 laut genug aber kratziger, x2 plus um 2.5 dB gedrosselte Toene passt.
    [baseline.csv]
2026-10-15 HW 4.x als Variante hw4x_cyclone_10 (Board-ID 5), unveraendert v4.01
    Uebernommen aus FPGA_source_alt\HW 4.x GOSOF80 - Multi SD: eigenes Top
    (top/GOSOF80_hw4x.vhd), SD_Card mit CRC/SPI_Master/soundtest/crc16 in rtl/hw4x,
    Gosof_PLL in rtl/cyclone_10. files_common.tcl aufgeteilt, Top/SD_Card/SDC kommen
    je Platinenfamilie aus files_hw2x.tcl bzw. files_hw4x.tcl (Options in variant.psd1).
    Abnahme: Synthese 2234/854/33792 = Altprojekt (Release v4.01), HW 2.x unveraendert.
    [baseline.csv]
2026-10-15 x.98: gemeinsamer Kern fuer HW 2.x/4.x, PLL-Takt, Options-DIPs neu, Versionsansage
    - top/GOSOF80.vhd ist jetzt gosof80_core, Platinenhuellen top/board_hw2x.vhd und
    board_hw4x.vhd (Entity gosof80), SD-Leser je Familie als sd_reader.
    HW 4.x laeuft damit auf demselben Kern (Votrax, Ansage, Soundtest, CRC).
    - CPU-Takt aus Gosof_PLL (892/1020 kHz ueber DIP1) auf allen Varianten; Cyclone II
    bekommt einen Teiler gleichen Namens (PLL schafft 892 kHz nicht). Beide Takte in
    GOSOF80.sdc logisch exklusiv.
    - Options-DIPs wie HW 4.x: DIP2 ON MP3 / OFF Votrax, DIP3 ON Testschalter wie
    Original / OFF Versionsansage, DIP4 Testmodus. Entfallen: 7-stufige
    Taktverstellung, DIP4 Sektor 660, Testmodus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
    [baseline.csv]
2026-10-15 x.98: Hintergrundmusik auf allen Platinen wie HW 2.x, cpu_clk_gen entfernt
    - MA-55-Hintergrundmusik jetzt auch auf HW 4.x (v4.01 hatte sie weggelassen).
    - rtl/common/cpu_clk_gen.vhd geloescht, der CPU-Takt kommt aus Gosof_PLL.
    - Hardwaretest hw2x_cyclone_IV_v4 (Ralf, 15.10.2026): x.98-Kern funktioniert.
    - Alle fuenf Varianten voll gebaut, keine negative Slack; baseline.csv und
    VARIANTEN.md mit den Fit-Werten.
    [baseline.csv]
2026-10-15 HW 3.x als Variante hw3x_cyclone_IV (Board-ID 6) auf dem x.98-Kern
    Uebernommen aus FPGA_source_alt\HW 3.x GOSOF80 - Multi SD - CycloneIV_v6
    (Release HW3.x v4.97). Der alte Top unterschied sich vom HW-2.x-Top nur in den
    Ports (SB_Opt 1..8, eigener SD_Error-Pin, LED_0 aus, DFP_rx-Eingang), daher
    direkt eigene Platinenhuelle top/board_hw3x.vhd, SD-Leser von HW 2.x.
    Build: Synthese 4633/2287/153600 = hw2x_cyclone_IV_v3 (gleicher Chip, gleicher
    Kern), 78 % LE, keine Timing-Verletzung, .jic 2.097.375 B. Nicht auf Hardware getestet.
    [baseline.csv]
2026-10-18 HW 5.x als Variante hw5x_cyclone_IV (Board-ID 7): ROMs aus dem EPCS4
    GOSOF 5.00 mit EP4CE6E22C8N-Core-Board, ohne SD-Karte. Neue sd_reader-Entity
    (rtl/hw5x, Flash_ROM aus WillFA7) liest 4 KB je Spiel aus dem
    Konfigurationsflash ab FLASH_BASE 0x40000; komprimierter Bitstream endet bei
    0x28668. Kern unveraendert, uebrige Varianten bitgleich (gen_qsf -Check).
    make_flash_hex.ps1 + gosof80_roms.cof fuer die lokale ROM-.jic,
    GHDL-Testbench sim/flash. Synthese 4441/2080/153600, Fit 74 % LE,
    Setup-Slack 2,098 ns. Nicht auf Hardware getestet.
    [baseline.csv]
2026-10-18 HW 5.x: ROM-.jic lokal in bin/, per .gitignore ausgeschlossen
    bin/HW5x_Cyclone_IV/GOSOF80_HW5.x_v7.98_roms.jic (Bitstream + Spiele 0-54 aus
    Gosof_Image_v1.21.img) enthaelt urheberrechtlich geschuetzte ROMs und wird
    ueber bin/*/*_roms.jic nie committet.
2026-10-18 HW 5.x: Flash_ROM v02 - Ruhephase mit CS high vor dem READ
    Hardwaretest (Core-Board allein): nach dem Einschalten blinkte LED1 (Slot
    leer), nach dem Reset-Taster lief das Laden. Nach der Konfiguration starteten
    die Register mit '0', CS ging ohne High-Phase auf Low, der EPCS4 streamte den
    geloeschten Bereich hinter dem Bitstream (4096 x FF).
    Jetzt: Zustand idle (50 us CS high, setzt alle Startwerte, auch ohne
    Reset-Puls), Flash_error im Erfolgsfall explizit '1', Reset-Taster
    synchronisiert. Testbench prueft den Einschaltfall (v01 scheitert, v02 PASS).
    Synthese 4489/2083/153600, Fit 74 % LE, Slack 2,065 ns.
    [baseline.csv]
2026-10-18 VARIANTEN.md: HW 5.x Hardwaretest 2 - v02 laedt Spiel 0, LED1 aktiv-low
    Core-Board allein, v02: LED1 bleibt beim Einschalten und nach dem Reset aus
    (Spiel geladen). Die Deutung "LED aktiv-high" aus Test 1 war falsch und ist
    korrigiert.
2026-10-28 HW 5.x: D1 zeigt den Flash-Fehler (Core-Board kopfueber, LED1 verdeckt)
    Auf GOSOF 5.00 steckt das Core-Board kopfueber, Core-LED1 ist nicht zu
    sehen. D1 blinkt jetzt bei leerem Slot mit. Pinbelegung per Messung
    bestaetigt (Stiftreihen getauscht, pins.tcl stimmt), Befund in VARIANTEN.md.
    [baseline.csv]
2026-10-28 HW 5.x: CPU-Takt aus dem Teiler statt der ALTPLL
    Die PLL eines EP4CE6-Core-Boards lieferte keinen Takt (Versorgung ok,
    Standalone-Test: zweites Board ok). Lader und Soundtest liefen, CPU nicht.
    hw5x nimmt jetzt RtlFamily cyclone_IV_div: Cyclone-IV-Megafunctions plus
    der Teiler aus rtl/cyclone_II, gleiche Frequenzen, laeuft auf jedem Board.
    +48 comb / +14 reg, Setup 1.624 ns, Hold 0.090 ns. Andere Varianten
    unveraendert (Synthese gegen Baseline).
    [baseline.csv]
2026-10-28 sim/plltest: PLL-Eingangstest fuer EP4CE6-Core-Boards, HW 5.x getestet
    Kleines Standalone-Design (LED1 = Gosof_PLL c0, LED2 = clk_50) mit
    build.ps1 und README. VARIANTEN.md: Teiler-Version laeuft auf beiden
    Core-Boards (Ralf, 28.10.2026).
2026-10-31 GOSOF80B: MA-766 (System 80B Gen 1) auf HW 5.x, Variante hw5x_80b_cyclone_IV
    Eigener Kern top/GOSOF80B.vhd: zwei T65 (1 MHz aus Teiler, keine PLL), 2 x AY-3-8913
    (ym2149_audio), SP0250 nach PinMAME, AD7528 als Multiplikation. 24 KB je Spiel im EPCS4,
    ROMs aus ..\Gosof80B\roms per make_flash_hex_80b.ps1. Generics Read_Bytes/Slot_Bytes in
    sd_reader_hw5x, CommonFiles in gen_qsf; alle anderen Varianten unveraendert gegen baseline.csv.
    Gegenueber dem Prototyp korrigiert: yrom1 auf $E000, CPU-Takt 1 MHz. Das SP0250 wird von allen
    Spielen fuer Klaenge genutzt, deshalb entgegen dem ersten Plan nachgebildet.
    Simuliert mit den echten ROMs (9 Spiele), sp0250 Sample fuer Sample gegen den C-Code.
    Nicht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
    [baseline.csv]
2026-10-31 docs: Evaluierung MA-886 (System 80B Gen 2/3)
    EPCS16 passt, E10 allein reicht nicht: 68 bis 110 M9K Bedarf gegen 46. Empfehlung E10 + EPCS16 +
    externes SRAM. Schaltplan fuer Gen 2 und Bone Busters fehlt noch.
2026-10-31 docs: MA-886 Evaluierung um A20, MA-1294 und Gen 2 ergaenzt
    A20 und MA-1294 verglichen: Digitalteil gleich, Analogteil anders.
    Gen 2 gegen Gen 3: dieselbe Grundplatine, Gen 2 mit AYs und per $2000
    verstellbarem MF-4, das PinMAME nicht nachbildet.
    GOSOF80B_MA766: Audiopegel anhand der Endstufe A5 (E-24715) praezisiert.
2026-11-01 GOSOF80B: Variante 80B_dev_open fuer Platine Gosof80B mit dev_open-Board
    Vorher hw5x_80b_cyclone_IV fuer GOSOF 5.00. Pins nach pins_Gosof80B.xlsx,
    S1 = Spiel, S2 = Optionen. Reset SW1 und LEDs in der Huelle invertiert,
    keine Pull-ups an Pin 89/90. EPCS16 mit unkomprimiertem Bitstream,
    FLASH_BASE 0x80000, 64 Slots. Kern unveraendert, +17 Comb.
    Schaltplanbefunde Gosof80B_01 in docs/GOSOF80B_MA766.md.
    Nicht auf Hardware getestet.
    [baseline.csv]
2026-11-02 GOSOF80B: MA-886 Gen 2 und Gen 3 auf dem E6 mit externem SRAM
    Neue Varianten 80B_ma886_gen2 (Board-ID 9) und 80B_ma886_gen3 (Board-ID 10)
    statt E10: eigener Kern top/GOSOF80B_886.vhd, ROMs im SRAM, MF-4 als SVF-Paar,
    jt51 fuer Gen 3. Bone Busters passt nicht auf den E6 und entfaellt.
    Flash_ROM.vhd: Slotrechnung kann jetzt 64-KB-Slots.
    Gebaut (Gen 2 64 % LE, Gen 3 90 % LE, 0,528 ns Setup), Kern mit echten ROMs
    simuliert (9 Spiele, jt51 nur als Stub). Nicht auf Hardware getestet und nicht
    abgehoert, Pins nicht gegen die Final-Netzliste geprueft.
    [baseline.csv]
2026-11-02 GOSOF80B: Variante 80B_dev_open heisst jetzt 80B_ma766
    Benennt die Variante nach dem Soundboard statt nach dem FPGA-Board, passend
    zu 80B_ma886_gen2/3. Synthese unveraendert: 3993/1739/229376, .jic 2.097.375 B.
    Die Dateien top/board_*_dev_open.vhd behalten ihren Namen, sie meinen das Board.
    [baseline.csv]
2026-11-02 bin/ aus dem Repo: Binaerdateien liegen auf lisy.dev
    Die .jic/.pof und changelog.txt bleiben lokal in bin/ und werden von Ralf auf
    https://lisy.dev/swrep/soundboards gestellt. release.ps1 schreibt weiter dorthin.
    Die Git-Historie bleibt unveraendert.
2026-11-02 docs: User Manual HW 5.x, README englisch, Startseite
    Handbuch GOSOF 5.00 auf Grundlage des HW-4.x-Handbuchs, auf v5 und x.98 gebracht
    (DIP-Baenke, Optionen, LEDs, Programmierung, ROMs). README englisch, Downloads auf
    lisy.dev, alle Varianten in der Tabelle.
2026-11-04 HW 5.x: ROMs ohne Quartus in die Release-.jic (add_roms_to_jic.ps1)
    scripts/add_roms_to_jic.ps1 setzt 4-KB-Slotdateien (-RomDir, NN_name.bin) oder
    ein GOSOF-SD-Image (-Image) direkt in das Flash-Abbild der .jic (bitgespiegelt)
    und rechnet die CRC-16/X.25 neu. Prueft den 6502-Reset-Vektor gegen den
    Platinentyp des Slots (0-7 MA-216, 8-15 MA-309, 16-31 MA-55, 32-47 MA-490,
    48-63 System 1). Release-.jic + Gosof_Image_v1.21.img ergibt byte-gleich die
    gosof80_roms.jic aus quartus_cpf (Fuellerluecken bleiben leer).
    release.ps1 prueft bei HW 5.x FlashBase-Default und Annahme der .jic und legt
    das Skript neben die .jic. Handbuch v1.01: Kapitel 8 neu, Anhang A mit
    Slotnummer, Anhang B zum Aufbau der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
2026-11-04 docs: Anhang A hebt die ON-DIPs farbig hervor (wie AtariFA)
2026-11-04 docs: Handbuch HW 5.x auf Deutsch und Franzoesisch, Sprachhinweis, Startseite und README
2026-11-09 docs: Bedienungsanleitung GOSOF80B (MA-766, MA-886 Gen 2/3), vorerst nur Deutsch
    Varianten, Spiele und DIP-Einstellungen aller drei Varianten, Startseite nennt System 80B.
2026-11-11 x.99: Beruhigungsfilter an S1..S16 (ca. 1 ms) fuer alle Varianten
    Black Hole (MA-216) mit Votrax-Emulation (DIP 2 OFF) spielte im Spiel keine
    Sprache: S16 kommt ueber das Treiberboard spaeter als S1..S8, die Firmware
    liest Port A nur einmal ca. 20 Takte nach dem PA7-IRQ. Sound_in uebernimmt
    die Eingaenge jetzt erst, wenn alle fuenf Leitungen 1000 cpu_clk-Takte stabil
    sind. Behebt im MP3-Weg auch die falsche Datei bei Sound 19/29/31.
    SwMinor 99. Alle 7 GOSOF80-Varianten mit -Fit gebaut: +20 Register, keine
    negative Slack, baseline.csv nachgezogen. Hardwaretest offen.
    [baseline.csv]
